Longan-Labs/CANBed2040_Res/README.md

# CANBed2040_Res
Resources for CANBed RP 2040
