Longan-Labs/CANBed2040_Res/CANBed2040.brd

## EAGLE design CANBed2040.brd (2021-11-22)

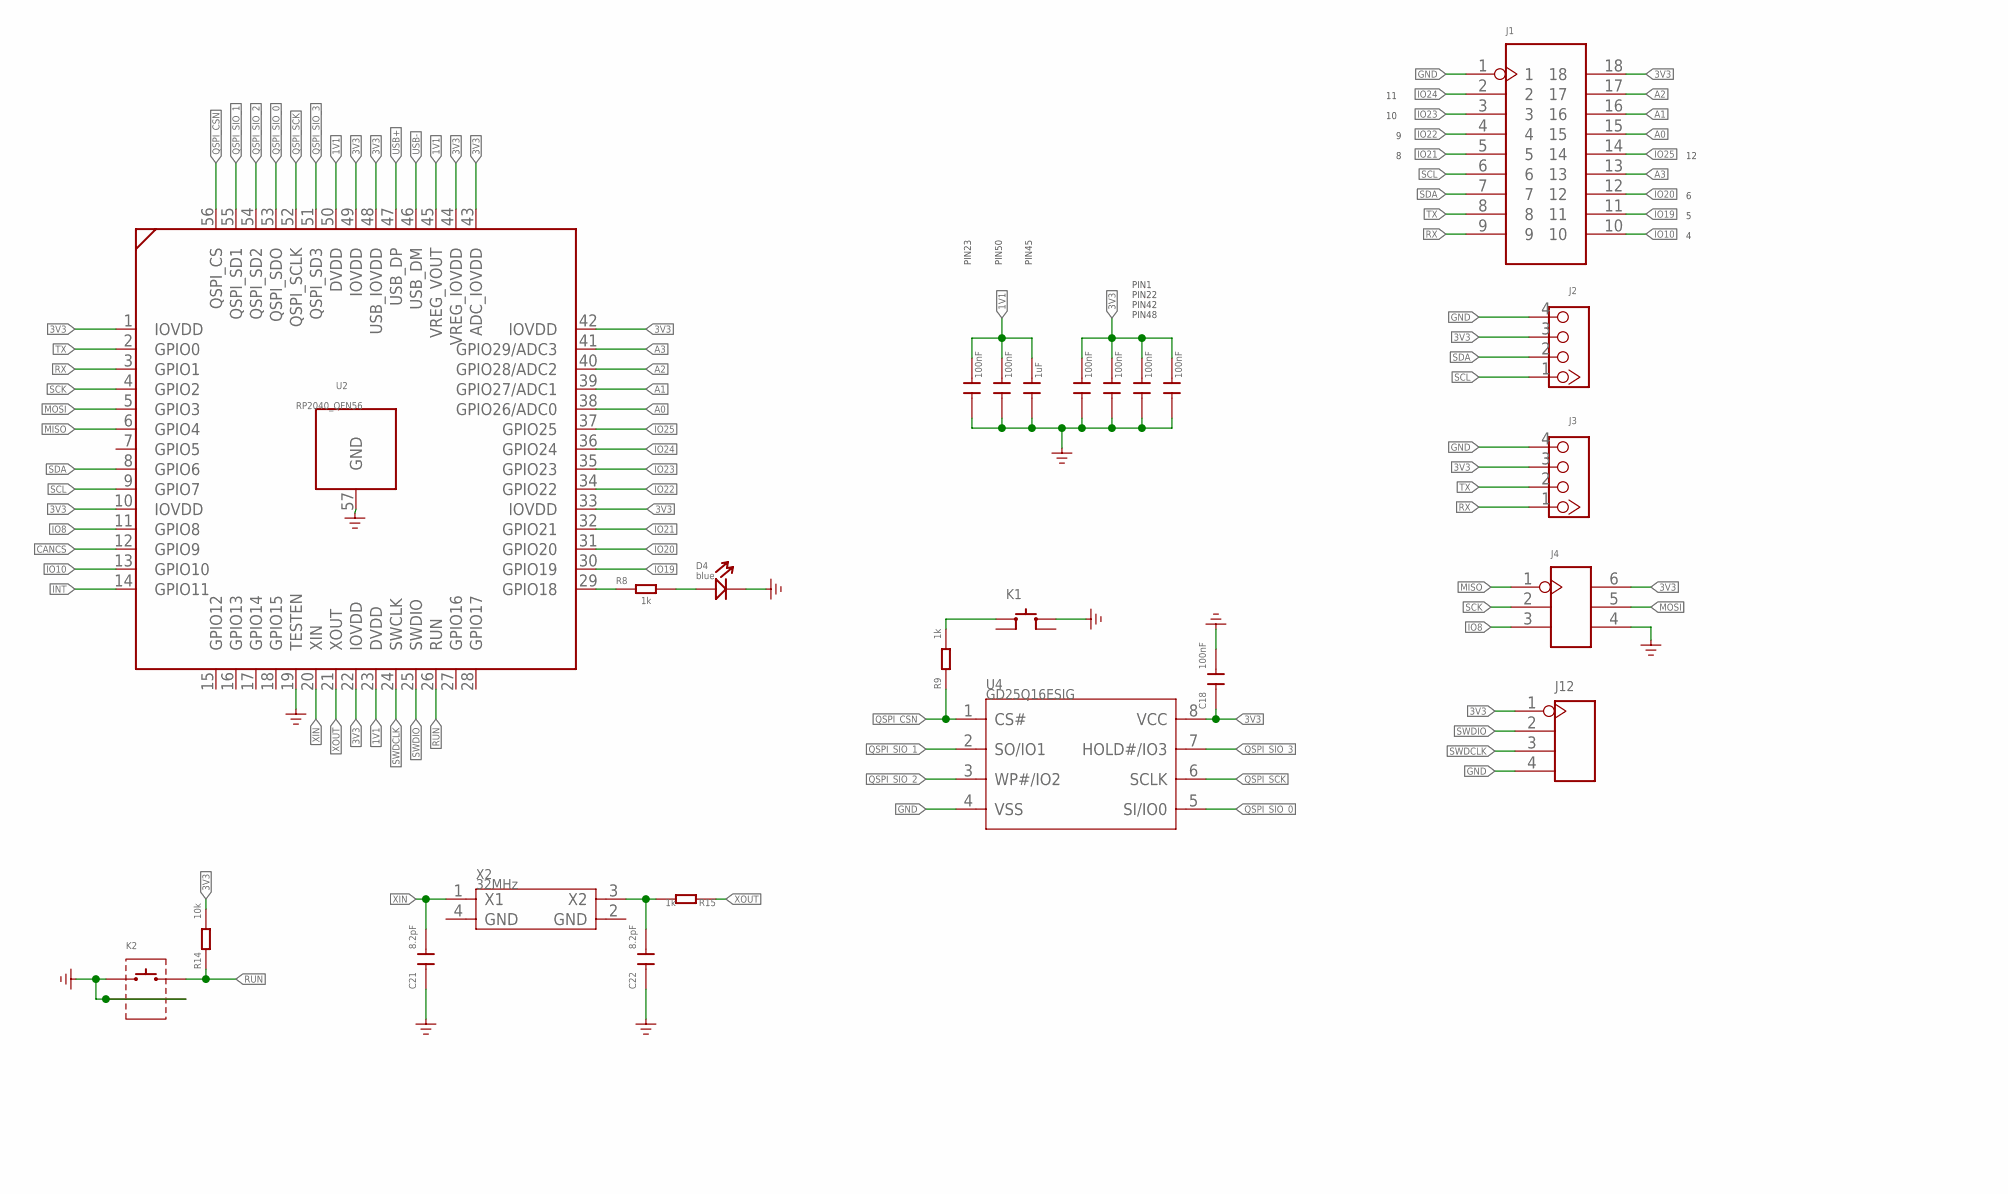
[picture p1: schematic CANBed2040.sch, sheet 1, part in row 1, column 1]

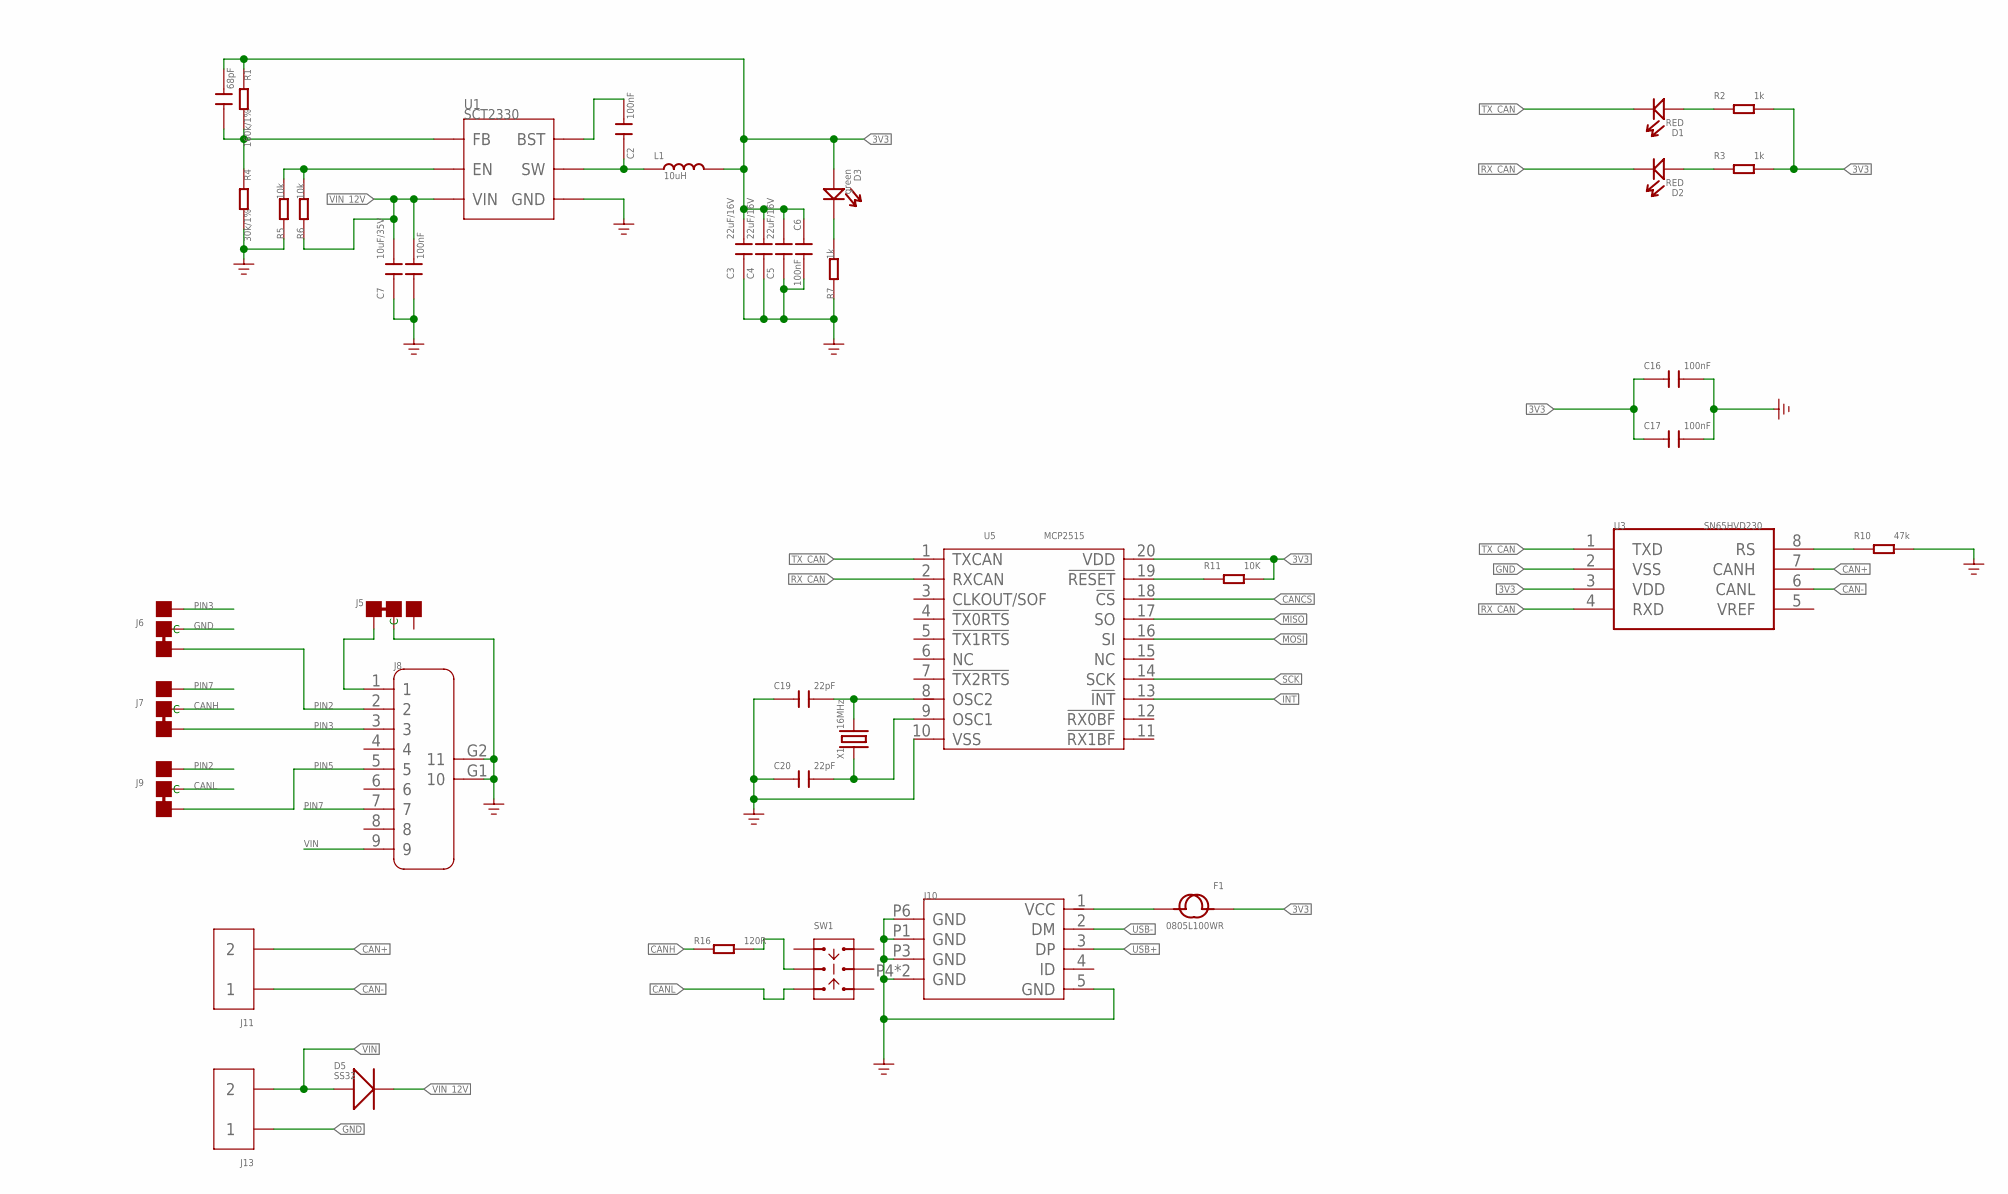
[picture p2: schematic CANBed2040.sch, sheet 1, part in row 1, column 2]

Parts:
C1: 68pF; C0603
C2, C6, C8, C9, C10, C12, C13, C14, C15, C16, C17, C18: 100nF; C0603
C3, C4, C5: 22uF/16V; C0805
C7: 10uF/35V; C1206
C11: 1uF; C0603
C19, C20: 22pF; C0603
C21, C22: 8.2pF; C0603
D1, D2: RED; LED-0603
D3: green; LED-0603
D4: blue; LED-0603
D5: SS32; DO-214AC
F1: 0805L100WR; F0805
J1: HEADER-2X9P-2.54; H2X9-2.54
J2, J3: 320110033; HW4-2.0
J4: HEADER-2X3P-2.54; H2X3-2.54
J5, J6, J7, J9: JUMPER-3P-SHORT; 3P-SMD-SHORT
J8: DB9'MEAL'; DB9-MEAL
J10: MICRO-USB5+4P-320010050; MICRO-USB5+5P-SMD-0.65-7.2X5.06MM
J11, J13: SCREW-TERMINAL-2P'5.08'; H2-5.0-10.5X8.0MM
J12: HEADER-4P-65/35MIL; H4-2.54
K1: BUTTON-4P-4.5X4.5; SW4-4.5X4.5X0.5MM
K2: BUTTON-2+2P; SW2+2P-7.7X2.75X3.95MM
L1: 10uH; INT2-SMD-6.6X7.1X3MM
R1: 160k/1%; R0603
R2, R3, R7, R8, R9, R15: 1k; R0603
R4: 30k/1%; R0603
R5, R6, R14: 10k; R0603
R10: 47k; R0603
R11: 10K; R0603
R16: 120R; R0603
SW1: SWITCH-2CH-6P-311010004; SW6-2.54-9.0X3.5X3.2+2.0MM
U1: SCT2330; SOT-23-6
U2: RP2040_QFN56
U3: SN65HVD230; SOIC8-6.0
U4: GD25Q16ESIG; SOP8-1.27-5.3X5.25X2MM
U5: MCP2515; TSSOP20-0.65-6.5X4.4MM
X1: 16MHz; X4-SMD-3.2X2.5X0.7MM
X2: 32MHz; X4-SMD-3.2X2.5X0.7MM

Connections:
1V1: C9.2, C10.2, C11.2, U2.23 (DVDD), U2.45 (VREG_VOUT), U2.50 (DVDD)
3V3: C1.2, C3.2, C4.2, C5.2, C6.1, C12.2, C13.2, C14.2, C15.2, C16.1, C17.1, C18.1, D3.+, F1.1, J1.18, J2.3, J3.3, J4.6, J12.1, L1.2, R1.1, R2.2, R3.2, R11.2, R14.2, U2.1 (IOVDD), U2.10 (IOVDD), U2.22 (IOVDD), U2.33 (IOVDD), U2.42 (IOVDD), U2.43 (ADC_IOVDD), U2.44 (VREG_IOVDD), U2.48 (USB_IOVDD), U2.49 (IOVDD), U3.3 (VDD), U4.8 (VCC), U5.20 (VDD)
A0: J1.15, U2.38 (GPIO26/ADC0)
A1: J1.16, U2.39 (GPIO27/ADC1)
A2: J1.17, U2.40 (GPIO28/ADC2)
A3: J1.13, U2.41 (GPIO29/ADC3)
CAN+: J11.2, U3.7 (CANH)
CAN-: J11.1, U3.6 (CANL)
CANCS: U2.12 (GPIO9), U5.18 (!CS)
CANH: J7.MM (C), R16.1
CANL: J9.MM (C), SW1.CH1B
EXT_PWR: F1.2, J10.1 (VCC)
GND: C3.1, C4.1, C5.1, C6.2, C7.1, C8.1, C9.1, C10.1, C11.1, C12.1, C13.1, C14.1, C15.1, C16.2, C17.2, C18.2, C19.1, C20.1, C21.1, C22.1, D4.-, J1.1, J2.4, J3.4, J4.4, J5.MM (C), J6.MM (C), J8.G1 (10), J8.G2 (11), J10.5 (GND), J10.P1 (GND), J10.P3 (GND), J10.P4 (GND), J10.P5 (GND), J10.P6 (GND), J12.4, J13.1, K1.3 (B0), K2.1, K2.S1, K2.S2, R4.2, R5.1, R7.1, R10.2, U1.4 (GND), U2.19 (TESTEN), U2.57 (GND), U3.2 (VSS), U4.4 (VSS), U5.10 (VSS)
INT: U2.14 (GPIO11), U5.13 (!INT)
IO8: J4.3, U2.11 (GPIO8)
IO10: J1.10, U2.13 (GPIO10)
IO19: J1.11, U2.30 (GPIO19)
IO20: J1.12, U2.31 (GPIO20)
IO21: J1.5, U2.32 (GPIO21)
IO22: J1.4, U2.34 (GPIO22)
IO23: J1.3, U2.35 (GPIO23)
IO24: J1.2, U2.36 (GPIO24)
IO25: J1.14, U2.37 (GPIO25)
MISO: J4.1, U2.6 (GPIO4), U5.17 (SO)
MOSI: J4.5, U2.5 (GPIO3), U5.16 (SI)
unnamed: D3.-, R7.2
unnamed: D1.+, R2.1
unnamed: R8.1, U2.29 (GPIO18)
unnamed: C1.1, R1.2, R4.1, U1.1 (FB)
unnamed: R16.2, SW1.COM1
unnamed: D4.+, R8.2
unnamed: K1.1 (A0), R9.2
unnamed: C22.2, R15.2, X2.3 (X2)
unnamed: R5.2, R6.2, U1.2 (EN)
unnamed: C2.2, U1.6 (BST)
unnamed: J5.11 (L), J8.1
unnamed: D2.+, R3.1
unnamed: C19.2, U5.8 (OSC2), X1.3 (2)
unnamed: C20.2, U5.9 (OSC1), X1.1
unnamed: C2.1, L1.1, U1.5 (SW)
unnamed: R10.1, U3.8 (RS)
PIN2: J6.11 (L), J8.2, J9.00 (R)
PIN3: J6.00 (R), J7.11 (L), J8.3
PIN5: J8.5, J9.11 (L)
PIN7: J7.00 (R), J8.7
QSPI_CSN: R9.1, U2.56 (QSPI_CS), U4.1 (CS#)
QSPI_SCK: U2.52 (QSPI_SCLK), U4.6 (SCLK)
QSPI_SIO_0: U2.53 (QSPI_SDO), U4.5 (SI/IO0)
QSPI_SIO_1: U2.55 (QSPI_SD1), U4.2 (SO/IO1)
QSPI_SIO_2: U2.54 (QSPI_SD2), U4.3 (WP#/IO2)
QSPI_SIO_3: U2.51 (QSPI_SD3), U4.7 (HOLD#/IO3)
RST_N: R11.1, U5.19 (!RESET)
RUN: K2.2, R14.1, U2.26 (RUN)
RX: J1.9, J3.1, U2.3 (GPIO1)
RX_CAN: D2.-, U3.4 (RXD), U5.2 (RXCAN)
SCK: J4.2, U2.4 (GPIO2), U5.14 (SCK)
SCL: J1.6, J2.1, U2.9 (GPIO7)
SDA: J1.7, J2.2, U2.8 (GPIO6)
SWDCLK: J12.3, U2.24 (SWCLK)
SWDIO: J12.2, U2.25 (SWDIO)
TX: J1.8, J3.2, U2.2 (GPIO0)
TX_CAN: D1.-, U3.1 (TXD), U5.1 (TXCAN)
USB+: J10.3 (DP), U2.47 (USB_DP)
USB-: J10.2 (DM), U2.46 (USB_DM)
VIN: D5.1 (+), J8.9, J13.2
VIN_12V: C7.2, C8.2, D5.2 (-), R6.1, U1.3 (VIN)
XIN: C21.2, U2.20 (XIN), X2.1 (X1)
XOUT: R15.1, U2.21 (XOUT)

Notes on the sheet:
PIN1
PIN22
PIN42
PIN48
PIN23
PIN50
PIN45

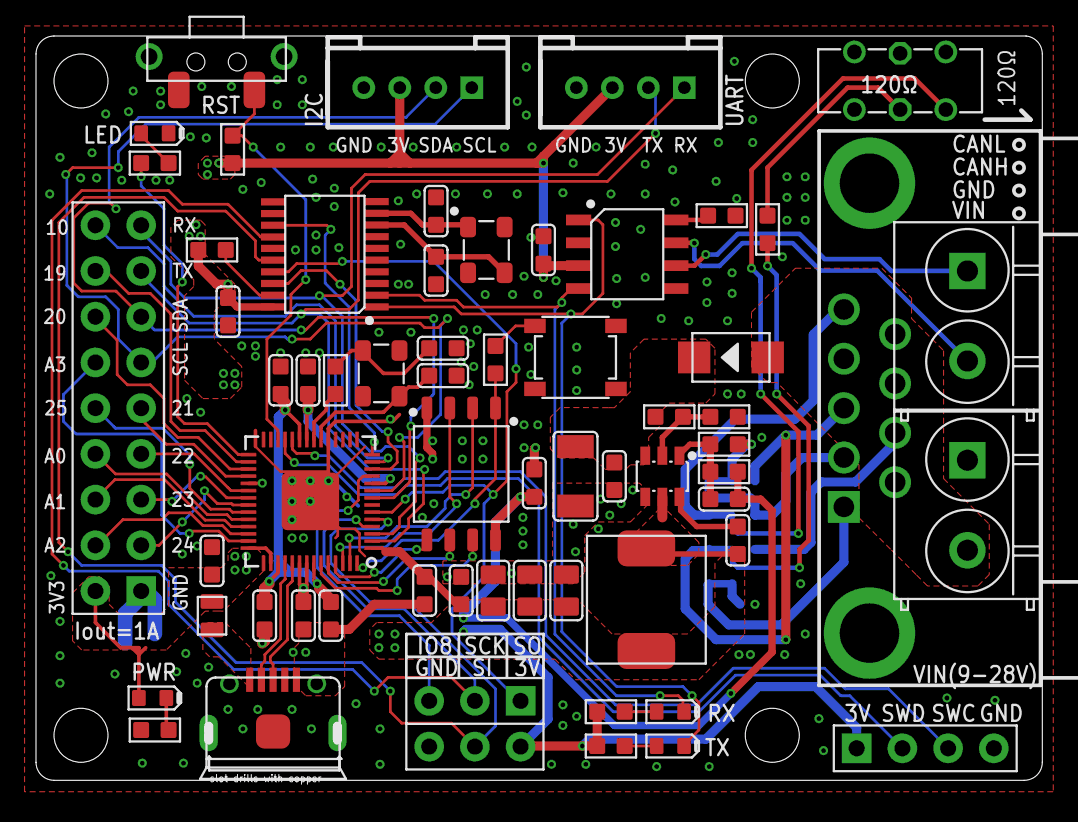
[picture p3: board CANBed2040.brd from above]

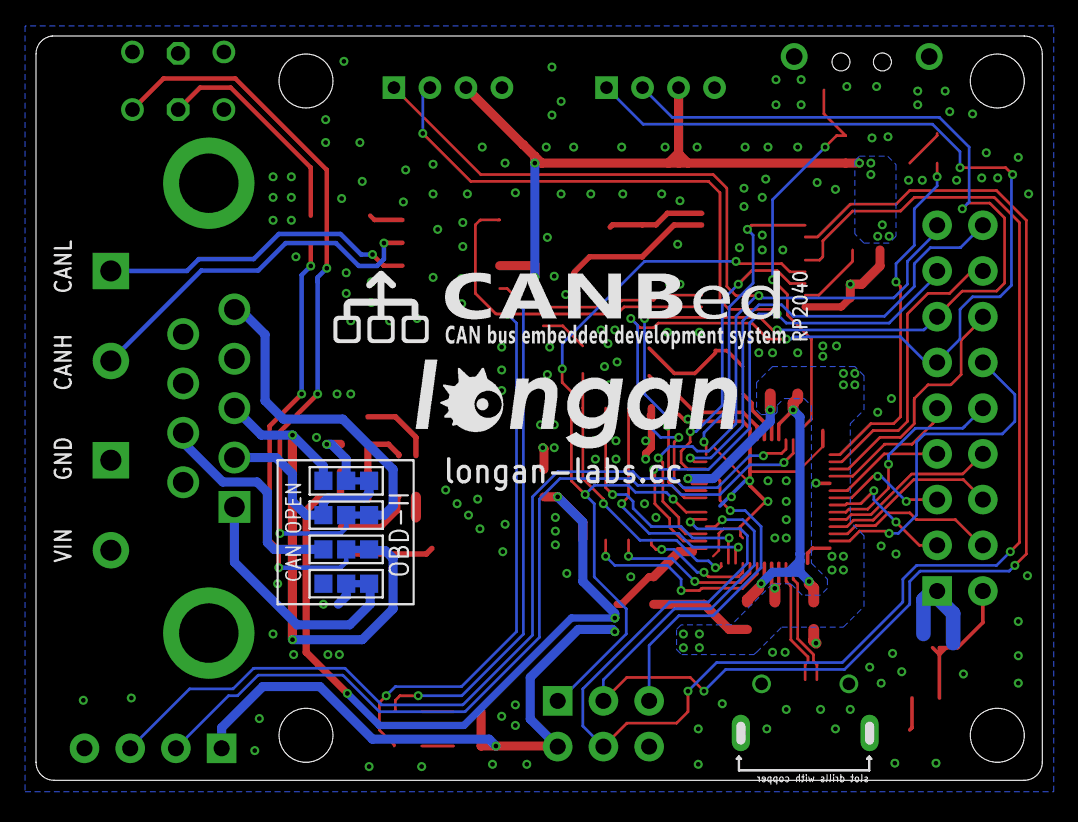
[picture p4: board CANBed2040.brd from below]

Board: 2 copper layers, 55.9 x 41.4 mm, 67 parts (5 on the bottom side), 68 nets.

Other parts of the board:
U$12: LONGAN-SILK-SMALL
